ozdadirri/shimano-ebike-hack/docs/img/bike.jpg

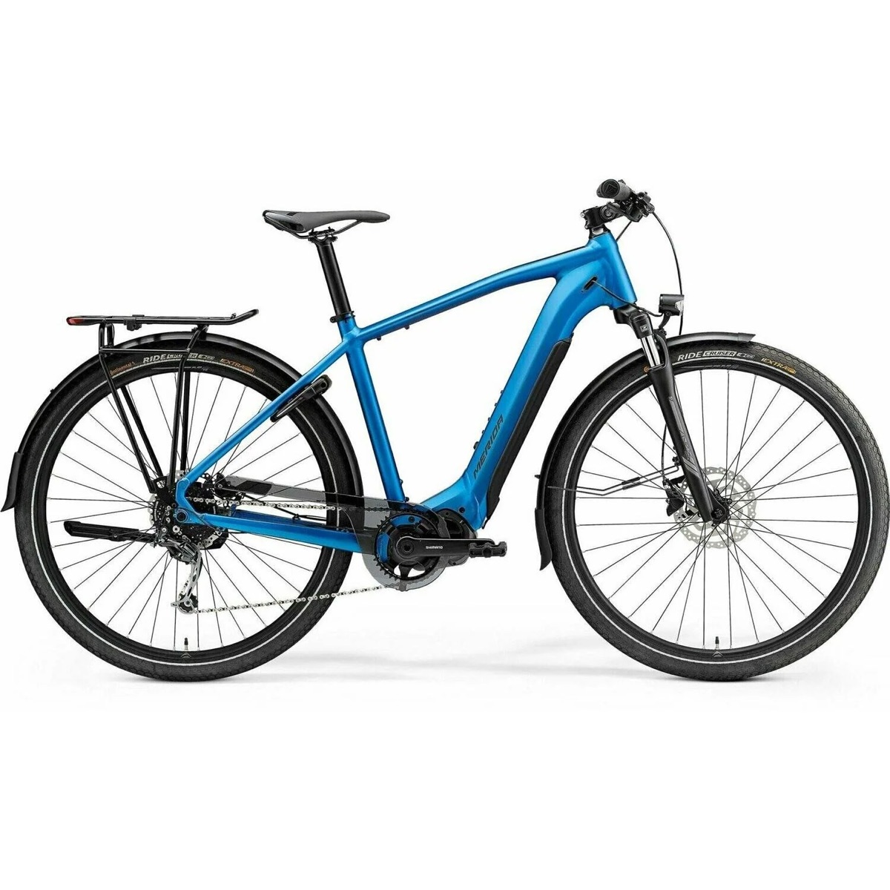
docs/img/bike.jpg
