ozdadirri/shimano-ebike-hack/hardware/bom.csv

section | ref | part | qty | notes | aud_low | aud_high
interface |  | Shimano EW-JC130 Junction B Y-cable 350/50/250 mm | 1 | Passive 3-plug splitter | 55 | 75
interface |  | Shimano EW-JC200 2-port junction | 2 | Couplers: motor cable to L2, L1 to pigtail | 60 | 80
interface |  | Shimano EW-SD50 E-TUBE cable 150 mm | 1 | Cut ~80 mm from one plug for the pigtail | 15 | 25
interface |  | Shimano TL-EW02 plug tool | 1 |  | 15 | 20
electronics | MCU | Seeed XIAO ESP32-S3 | 1 |  | 15 | 20
electronics | U2 | TLV3501AIDBVR comparator + SOT-23-6 adapter | 1 | Rail-to-rail input, 4.5 ns | 7 | 10
electronics | U1 | Pololu D36V6F3 3.3 V buck module | 1 | 4.2-50 V in | 12 | 15
electronics | C1 | 1 nF C0G 100 V 0805 | 2 |  | 1 | 1
electronics | L1 | 470 uH inductor, >=150 mA, SRF > 2 MHz | 1 |  | 2 | 4
electronics | F1 | PTC fuse 100 mA hold (200 mA with screen on bus power) | 1 |  | 1 | 1
electronics | D1 | SS14 Schottky | 1 |  | 0.5 | 0.5
electronics | TVS1 | SMAJ15A TVS | 1 |  | 1 | 1
electronics | D2 | BAT54S dual Schottky | 1 |  | 0.5 | 0.5
electronics | R1-R7 | 10k, 2x100k, 1M (+2.2M, 470k spares), 2x47k, 100R (0805) | 8 |  | 5 | 5
electronics | RV1 | 10k trimmer (Bourns 3314J) | 1 |  | 2 | 3
electronics | C2/C4 | 10 uF 25 V + 3x 100 nF ceramic | 4 |  | 2 | 2
electronics | C3 | 100 uF 6.3 V (1210 ceramic or SMD electrolytic) | 1 |  | 1 | 1
electronics | JP1 | 2-pin header + jumper | 1 |  | 0.5 | 0.5
electronics | PCB | 60x40 mm 2-layer PCB (JLCPCB, 5 pcs, + shipping) | 1 |  | 4 | 10
electronics |  | Wire, glue-lined heat-shrink, conformal coating | 1 |  | 20 | 25
button_addon | U3 | MCP23008-E/P I2C GPIO expander | 1 |  | 3 | 4
button_addon | K1-K3 | AQY212EH PhotoMOS relay | 3 |  | 9 | 15
button_addon | R8-R10 | 470R resistor | 3 |  | 1 | 1
button_addon | J3 | JST-PH 4-pin pair | 1 |  | 3 | 3
button_addon |  | 30 AWG Kynar wire, neutral-cure silicone | 1 |  | 18 | 20
case |  | M3 heat-set inserts | 6 | Pack | 8 | 12
case |  | M3x30 socket-head screws (stainless) | 4 |  | 4 | 4
case |  | M3x10 socket-head screws (stainless) | 2 |  | 2 | 2
case |  | M2.5x6 self-tapping screws | 4 |  | 3 | 3
case |  | PG7 IP68 cable gland | 1 |  | 3 | 5
case |  | 1 mm clear polycarbonate (68x54 mm) | 1 |  | 8 | 12
case |  | 3M VHB 0.25 mm tape | 1 |  | 10 | 10
case |  | 1.5 mm EVA foam pads | 4 |  | 5 | 5
case |  | Rubber straps or 12 mm hook-and-loop | 2 |  | 8 | 8
case |  | USB-C silicone dust plug | 1 |  | 3 | 3
case |  | PETG ~150 g, TPU ~15 g | 1 |  | 0 | 0
tools |  | Oscilloscope >= 20 MHz | 1 |  | 110 | 250
tools |  | 24 MHz USB logic analyzer | 1 |  | 15 | 25
tools |  | Multimeter | 1 |  | 30 | 50
tools |  | ADuM3160 USB isolator | 1 |  | 25 | 35
