ozdadirri/shimano-ebike-hack/(commit log)

2026-10-25 Add DIY E-TUBE tap project: guide, firmware, tools, case and drawings
    - Illustrated build manual (docs/), standalone index.html for GitHub Pages
    - ESP-IDF v5 capture firmware for ESP32-S3 (RMT + DMA, USB logger, self-test)
    - Python decoder with a simulated-frame test, docs and drawing export scripts
    - Parametric OpenSCAD head-unit case, AUD parts list, 22 SVG drawings
    [bom.csv, etube_case.scad]
2026-10-25 Add bike photo and name the model eSpresso 400 S EQ
    - Photo of the Merida eSpresso 400 S EQ with callouts in the guide overview and README
    - Rebuild docs/index.html; skip photos when exporting drawings
    [export_drawings.py]
2026-10-25 README: link the guide site, add dashboard and PCB images
2026-10-25 Add Ride Audio add-on: Spotify remote, internet radio, MP3 and Spotify Connect
    - New docs/media-guide.html (standalone docs/media.html), linked from the main guide
    - Four touchscreen screen designs as SVG: ride + mini player, Spotify, radio, MP3
    - BLE media keys + Apple Media Service, Spotify Web API, MAX98357A I2S audio wiring
    - build_docs.py builds both pages; README shows the screen designs
2026-10-25 Radio screen: rename sample station genre to Pop
2026-10-25 Add OpenSCAD case screenshot to README and guide
2026-10-25 Use the exploded case screenshot with the handlebar mount
2026-10-25 Case: add Garmin quarter-turn adapter and fit-test part
    - etube_case.scad: garmin and garmin_test parts, g_* parameters, MOUNT switch for the assembly view
    - Guide: Garmin adapter section with drawings and fit-test steps; link to the .scad
    instead of pasting a copy that can go stale
    - README: Garmin mount notes
    [etube_case.scad]
2026-10-25 README: show the Garmin-compatible mount render
